TimChild/DurangoTransfercase/Resources/Wiring Diagrams/connectors.png

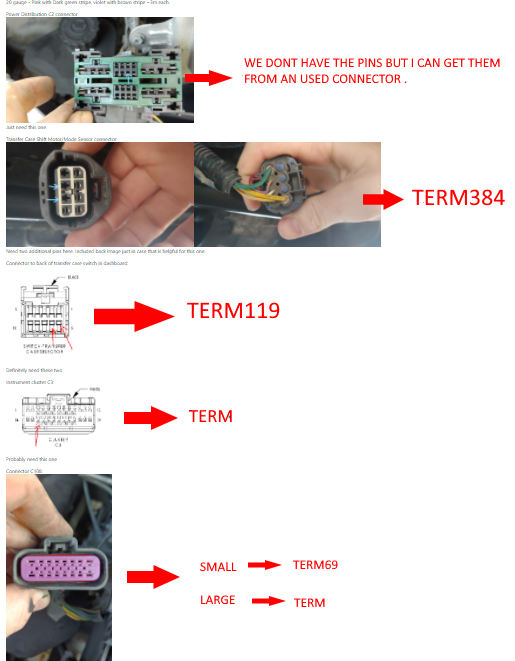
Resources/Wiring Diagrams/connectors.png
