TimChild/DurangoTransfercase/Resources/Arduino/Cat Images/CatFace.jpg

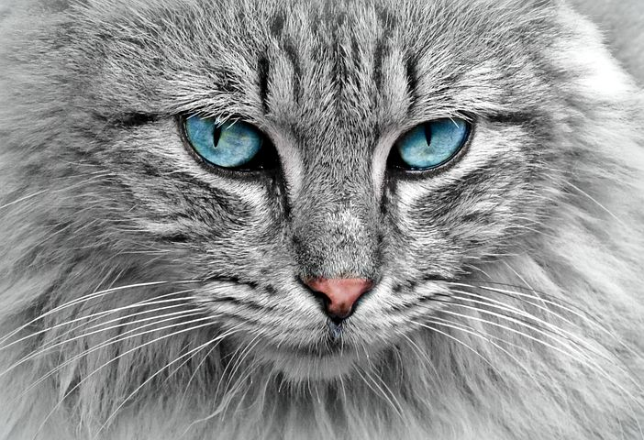
Resources/Arduino/Cat Images/CatFace.jpg
