TimChild/DurangoTransfercase/Resources/Arduino/Cat Images/BW_cartoon.jpg

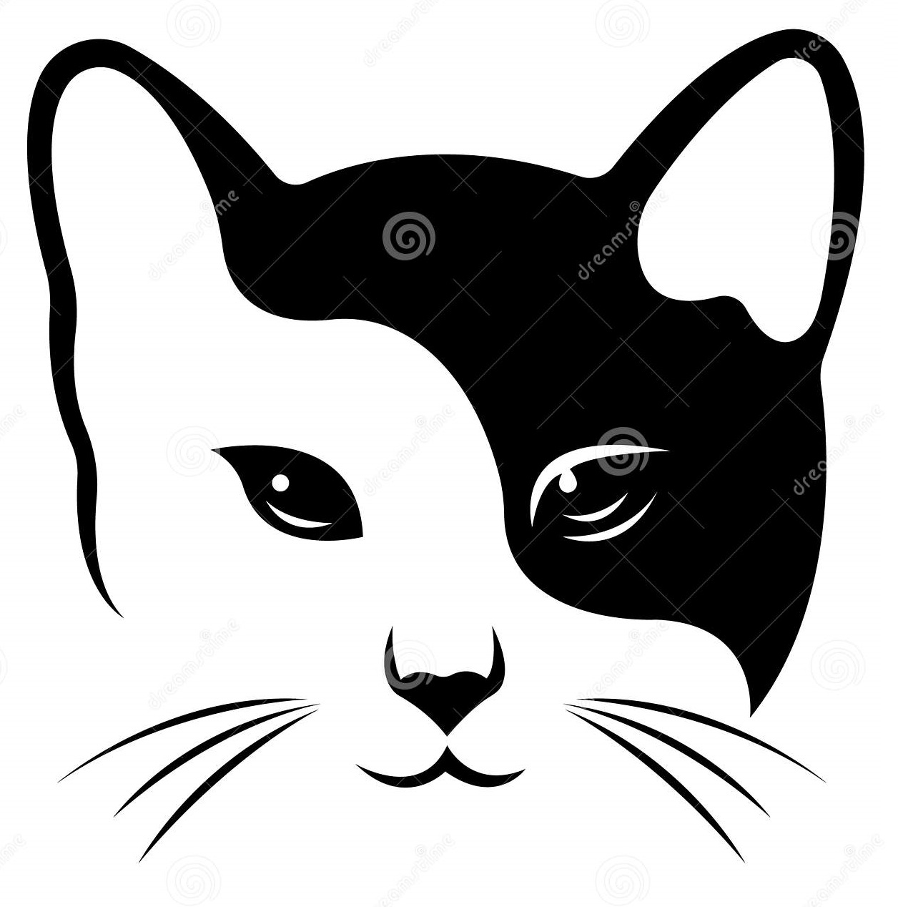
Resources/Arduino/Cat Images/BW_cartoon.jpg
