TimChild/DurangoTransfercase/Resources/Wiring Diagrams/Full Diagnosis Diagram.pdf

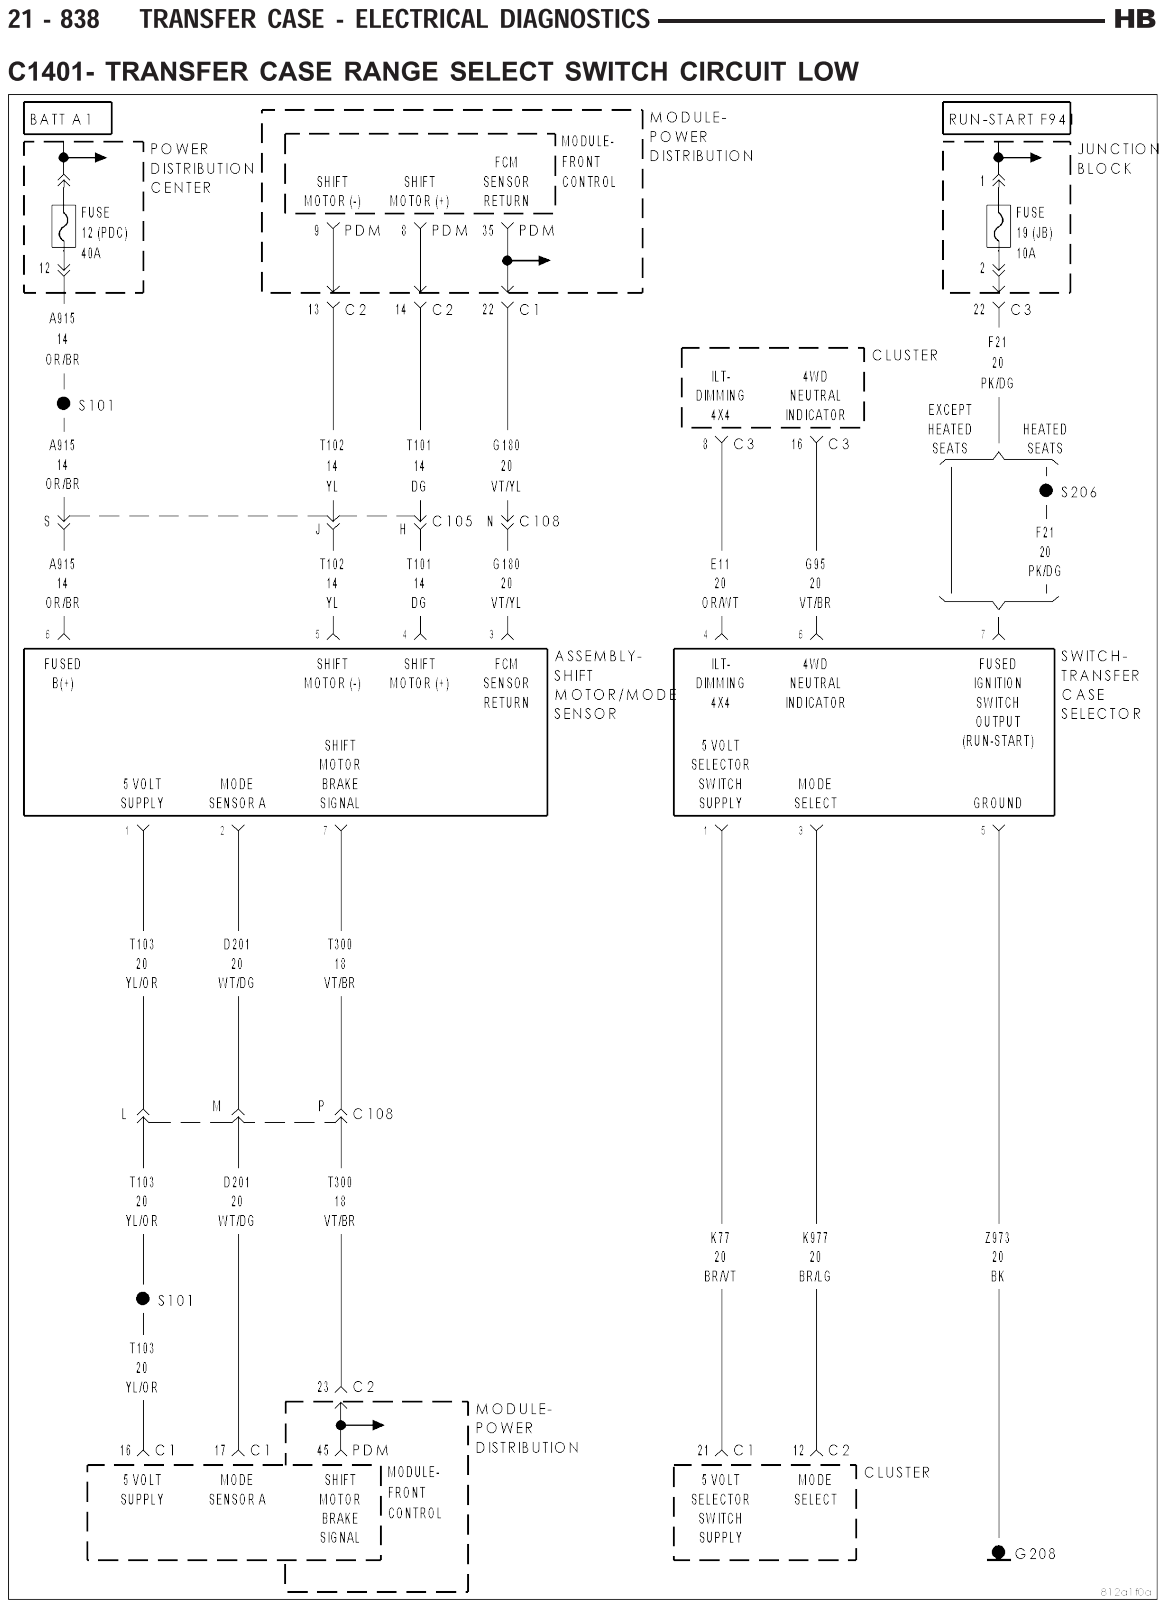
[picture p24: page 1]
