TimChild/DurangoTransfercase/Resources/Wiring Diagrams/Shift Motor Diagram.pdf

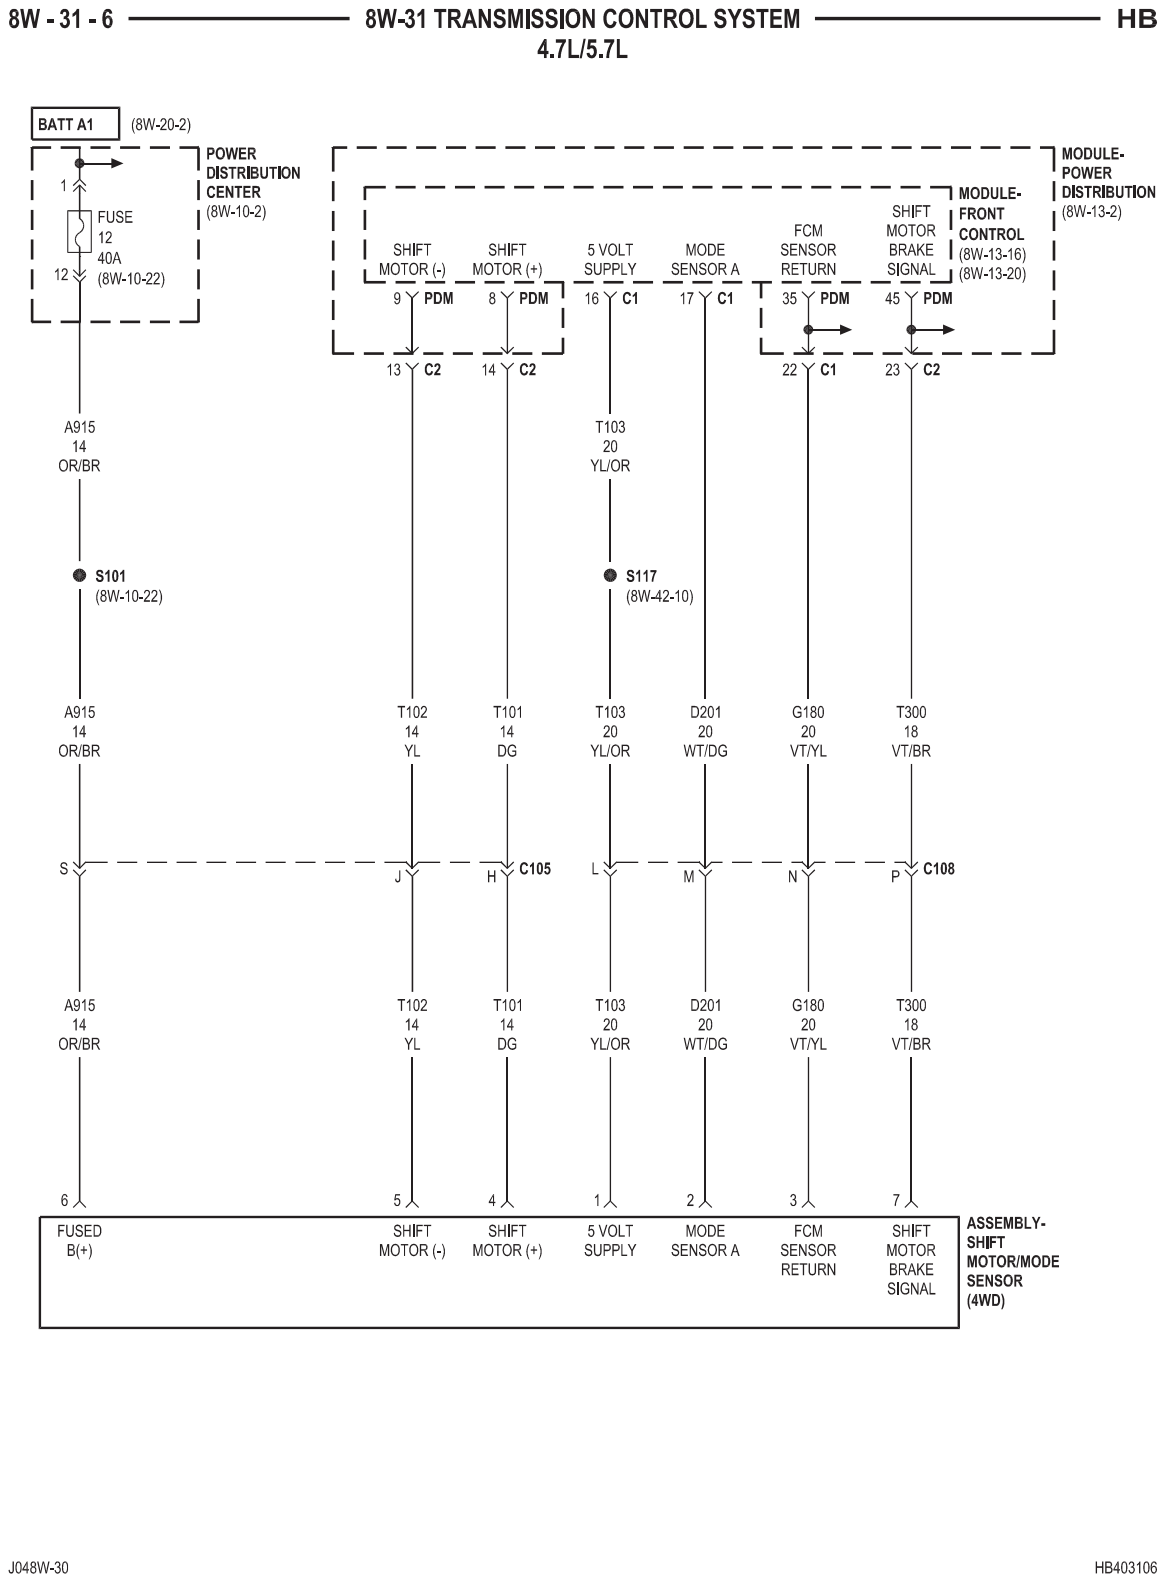
[picture p25: page 1]
