TimChild/DurangoTransfercase/Resources/Wiring Diagrams/Switch Diagram.pdf

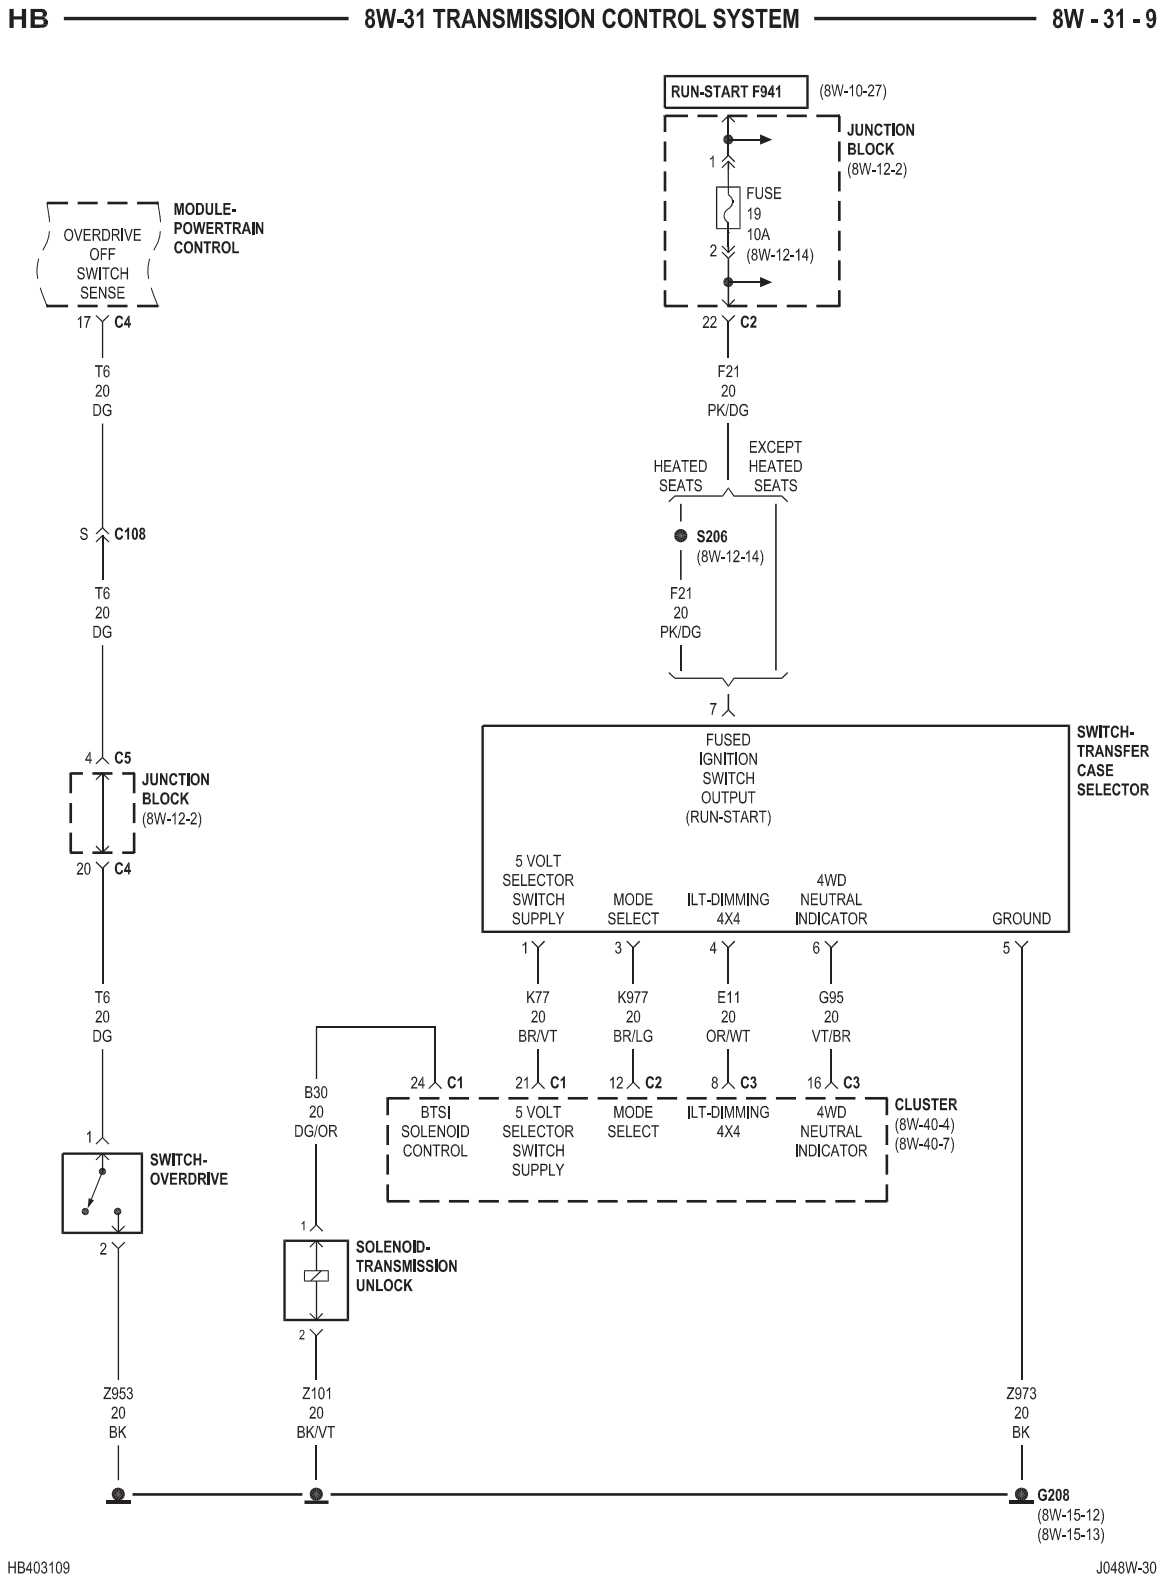
[picture p26: page 1]
