TimChild/DurangoTransfercase/(commit log)

2021-08-15 Lots of gaps filled in, not tested
    Filled in a lot of the missing functions, not complete or tested
    [main.cpp, motor.h, output.h, specifications.h, switch.h]
2021-08-16 Mostly updates to Motor
2021-08-16 Somewhat setup LiquidCrystal stuff
    Sort of got it working as in it compiles, but pretty sure I am doing something horribly wrong with how I am initializing the Output class.
    [main.cpp, motor.h, output.h, switch.h]
2021-09-05 Started testing, LCD working, switch working
2021-09-06 Motor controllable now, but not moving properly.
2021-09-06 Added lots of debugging serial writes. Fixed quite a few problems within attempt shift
    Also some other stuff like using F() to store strings in program memory instead of RAM.
    [main.cpp, motor.h, specifications.h]
2021-09-07 Working, but needs further work to figure out what happens with failed shifts etc
    [main.cpp, motor.h, specifications.h, switch.h]
2021-09-23 Modified to work with an ST7735 TFT screen instead of LCD. Bug causes crash
    Currently there is a problem with sending SPI commands to the TFT screen as well as using Serial.print()... not sure how to get around this yet.
    [main.cpp, motor.h, output.h, specifications.h, switch.h]
2021-09-23 Changed Serial.prints to only occur if #define DEBUG is present
2021-09-25 Finally not crashing with the TFT screen
    [main.cpp, output.h]
2021-09-26 Few minor fixes to switch Neutral
    [output.h, switch.h]
2021-10-01 two steps forward 2 steps back
    Added Definitions for positions 0 - 3
    Improved main message output area so that up to 4 lines of text will be displayed correctly
    Fixed some issues with switch selection, but it's still wrong
    I think the way I was defining DEBUGPRINT etc was wrong, so I changed it, but it is still wrong, maybe it was right before? Not sure
    [main.cpp, motor.h, output.h, specifications.h, switch.h]
2021-10-02 FINALLY fixed switch N toggle. String was overflowing by 1 character
    [main.cpp, output.h, switch.h]
2021-10-06 Finally fixed an overflow issue
    I must have at some point been copying an 84 character string into an array with size 84 instead of size 85 (for the /0). And that was causing undefined behaviour.
    Also added defines for AWD, NEUTRAL etc ..
    [main.cpp, motor.h, output.h, specifications.h, switch.h]
2021-10-16 Added wait until reset behaviour for failed shift attempt
    [main.cpp, motor.h, output.h, specifications.h, switch.h]
2021-10-17 Improved failed shift behaviour
    [main.cpp, motor.h, specifications.h, switch.h]
2021-10-17 Further improved failed shift behaviour
    Also added random color cat, and fixed some types for pins
    [main.cpp, motor.h, output.h, specifications.h, switch.h]
2021-11-12 Accounting for 1k inline resistor on output of Cluster 5V
2021-11-13 Allowing wider range on Neutral (doesn't fall in specs for some reason)
    [switch.h]
2021-11-13 Reverting the check Vout behaviour (which doesn't make sense)
    [main.cpp, motor.h]
2021-11-13 Added a bit of additional tolerance to motor position
    [main.cpp, motor.h, specifications.h]
2021-11-20 Allow shift to be "successful" if ending in correct position without reaching target V
    [motor.h]
2021-11-20 Changed to single target voltage for motor positions instead of low and high limits
2021-11-20 Added some averaging to reading motor volts (~1ms per read vs 0.1ms now)
2021-11-20 Increased max power to full, and increased min power from 25/255 to 35/255
2021-11-20 Pause before main loop if switch != motor on startup
2021-11-28 Switched to exponential averaging which should be more reliable
2021-11-28 Added check for disconnected motor and ensure no shift occurs from bootup
2021-12-12 Hopefully fixed the switch resistance measurement?
    [switch.h]
2021-12-15 ReadOnly mode. Trying to figure out ADCs
    Switched back to basic averaging
    Added a throw away measurement before real measurements
    Made a read only mode to hopefully make it easier to see what's going on
2021-12-16 Update to inline resistance before switch
2021-12-17 Update resistance show if more than 1.5% change rather than fixed 15 ohms
    [output.h]
2021-12-17 Reduce lower limit on AWD resistance
    Both 4Hi and 4Lo seem to be perfectly in spec now, but AWD is about 60 ohms too low. Don't see any reason not to increase the range which is acceptable for AWD
    [specifications.h]
2021-12-17 Temporarily set Motor ADC pin mode as INPUT_PULLUP
    Want to make sure that it isn't shorted to something else. It should definitely show 5V with pullup on it when disconnected
    [motor.h]
2021-12-17 Motor back to INPUT not INPUT_PULLUP
    with Pullup the value did stay close to 5V so I don't think there is a short
    [motor.h]
2021-12-17 Reduced low limit of N switch resistance
    Since I'm guessing the internal resistance of the clusters 5V my readings are off a little.
2021-12-19 Back to normal operation, new N resistance limits
2021-12-20 mostly minor changes, possible fix to multiple shift attempts
    [main.cpp, motor.h, switch.h]
2021-12-20 Reduce position tolerance, change limit on disconnected check
    Reduce position tolerance when shifting (i.e. stop within 0.05 instead of 0.1V)
    Check for V > 4.85V with pullup on to indicate disconnected
    If disconnected motor, initialize selector before reading it.
    [main.cpp, motor.h, specifications.h]
2022-02-06 Added other project resources to repo
    [WiringSchematic.kicad_pcb, WiringSchematic.sch]
2022-02-06 Updates to wiring diagram
    [WiringSchematic.sch]
2022-02-08 Updates to circuit diagram -- Switched some pins
    Now using D2/3 for manual control, and 6/7 for Motor PWM
    [WiringSchematic.sch]
2022-02-08 Added manual mode to Arduino (switched IO pins)
    Added a manual control mode along with some other smaller changes.
    Also changed some of the pins that are used for IO
2022-02-12 Updates to wiring diagram and tweaks to code
2022-02-22 Use max motor power in manual mode
    Currently only using ~70% of max power in automatic mode. In case it gets stuck somewhere, it is better to have access to 100% motor power somehow. Now that is true in manual mode.
    [main.cpp, specifications.h]
2022-08-23 Reduce SPI speed, Fix box size, set margins
    [output.h]
2024-10-19 update neutral resistance range
